osresearch/psionpi/(threads)

Thread 1 (2023-07-01):

Series 5 and 5mx display compatibility

yota9, 2023-07-01:
Hi! I'm writing it mostly for my self. I was wondering about display compatibility of series 5 and 5mx (despite of obviously different flex cable they looks very similar). It has 22 contacts instead of 26 (2 for the backlight are separated + 2 are unused on 5mx). So this what I've got on series 5 pinout:

1 - DIGI
2 - DIGI 3.3V
3 - DIGI
4 - DIGI
5 - GND (DIGI no connection)
6 - 3.3 V
7 - 19.81 v
8 - 18.3v
9 - 1.5v
10 - 16.8v
11 - 3v
12 - GND
13 - rare pulse 50hz?
14 - clock?
15 - 18 - data
19 - 3.12v
20 - rarest pulse 50 msec?
21 - 50% duty square wave 1.7v
22 - GND

So at least what I see is that it doesn't have negative voltage, so it seems to be it is not possible to just swap and the displays are incompatible. Maybe it would would save a bit time someone (don't belive it would actually :)), anyway I've decided to drop my conclutions here.
