osresearch/psionpi/(commit log)

2021-07-17 lcd pinout: definite grounds
2021-07-18 fix some voltages and lcd part number
2021-07-19 digitizer values and contrast voltage
2021-07-21 psion display driver
2021-07-21 (small) framebuffer works
2021-07-21 uart fb works
2021-07-22 spi_display: fix bug in x_end computation
    [spi_display.v]
